sbcarlton/prosthetic-hand/IMG_2657.jpg

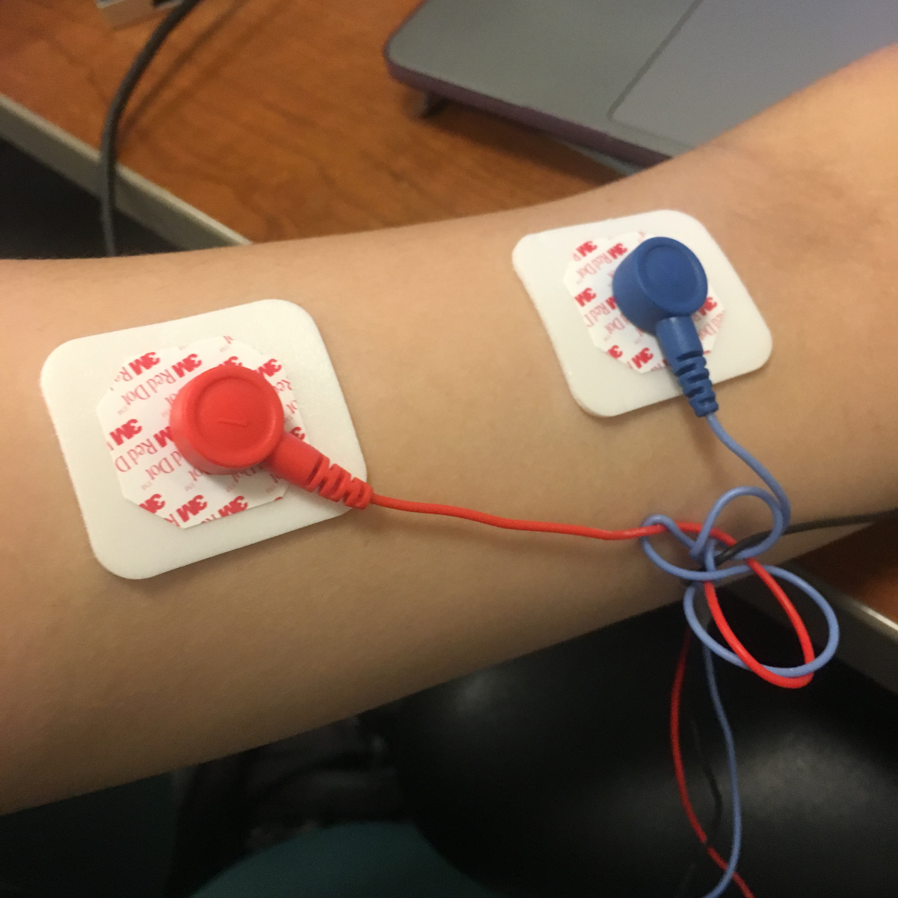
IMG_2657.jpg
