sbcarlton/prosthetic-hand/README.md

# prosthetic-hand
code for an EMG driven 3D printed prosthetic hand created as a senior project for independent research at UC Berkeley
