sbcarlton/prosthetic-hand/IMG_2658.jpg

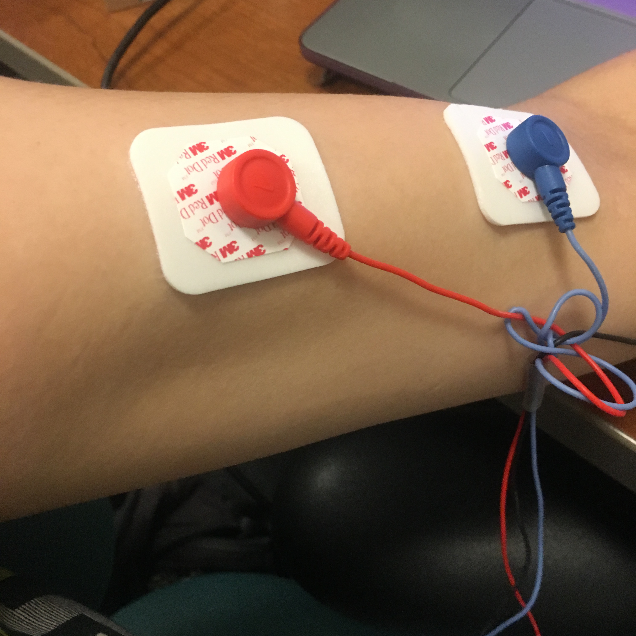
IMG_2658.jpg
