sbcarlton/prosthetic-hand/IMG_2659.jpg

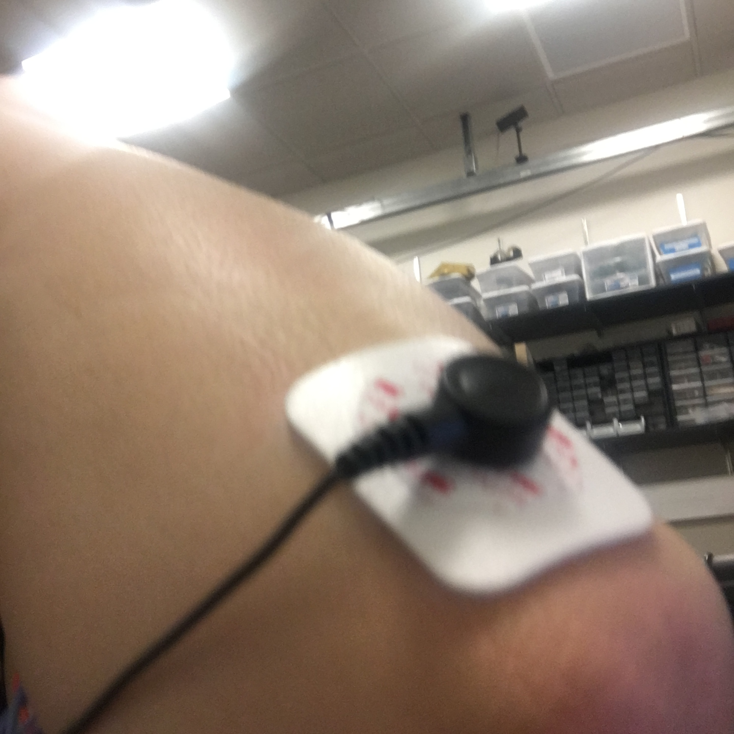
IMG_2659.jpg
