sbcarlton/prosthetic-hand/IMG_2660.jpg

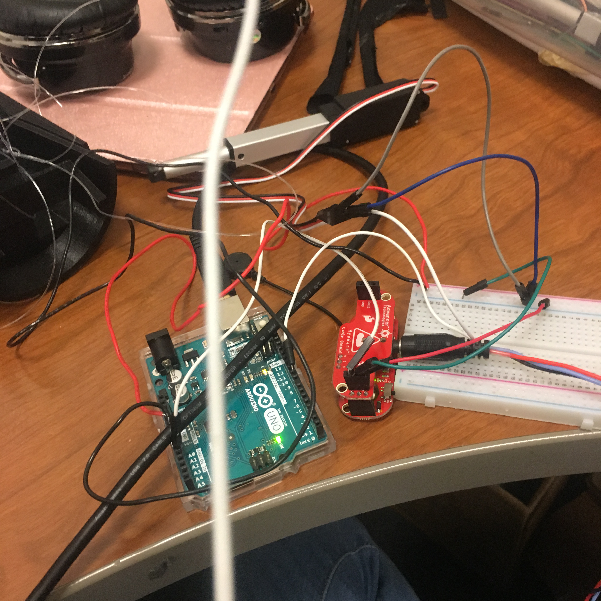
IMG_2660.jpg
