sbcarlton/prosthetic-hand/IMG_2662.jpg

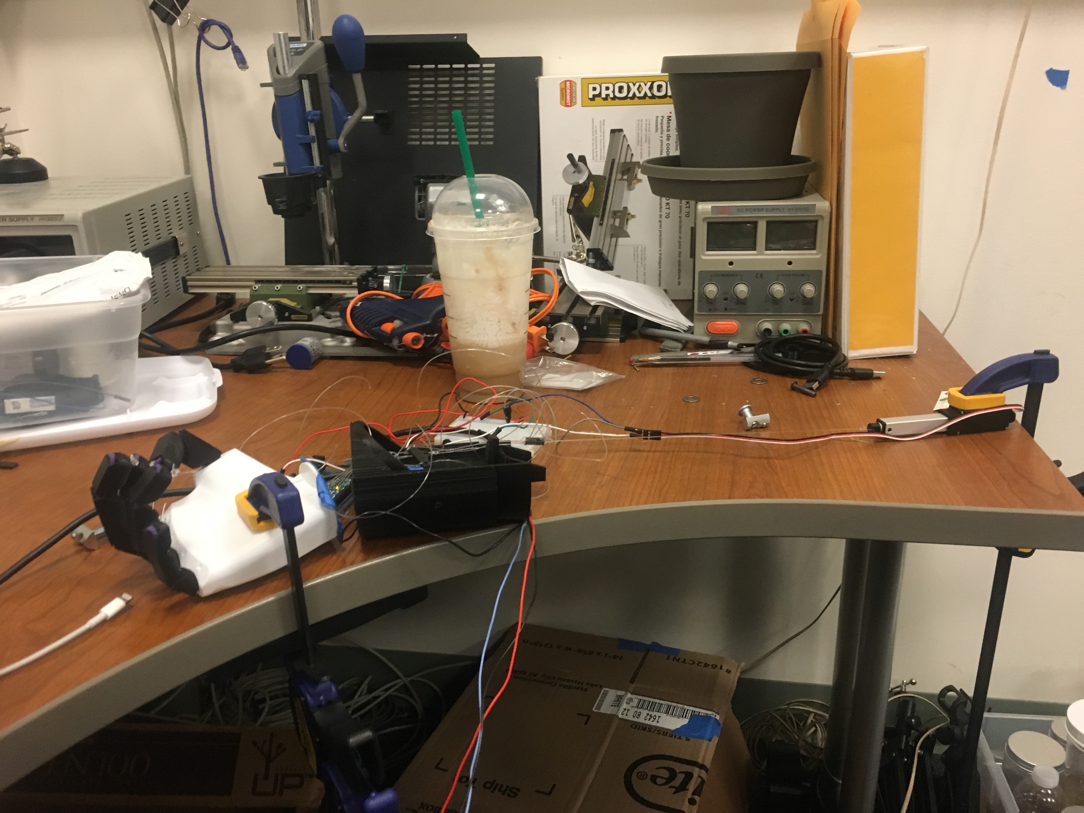
IMG_2662.jpg
