sbcarlton/prosthetic-hand/IMG_2663.jpg

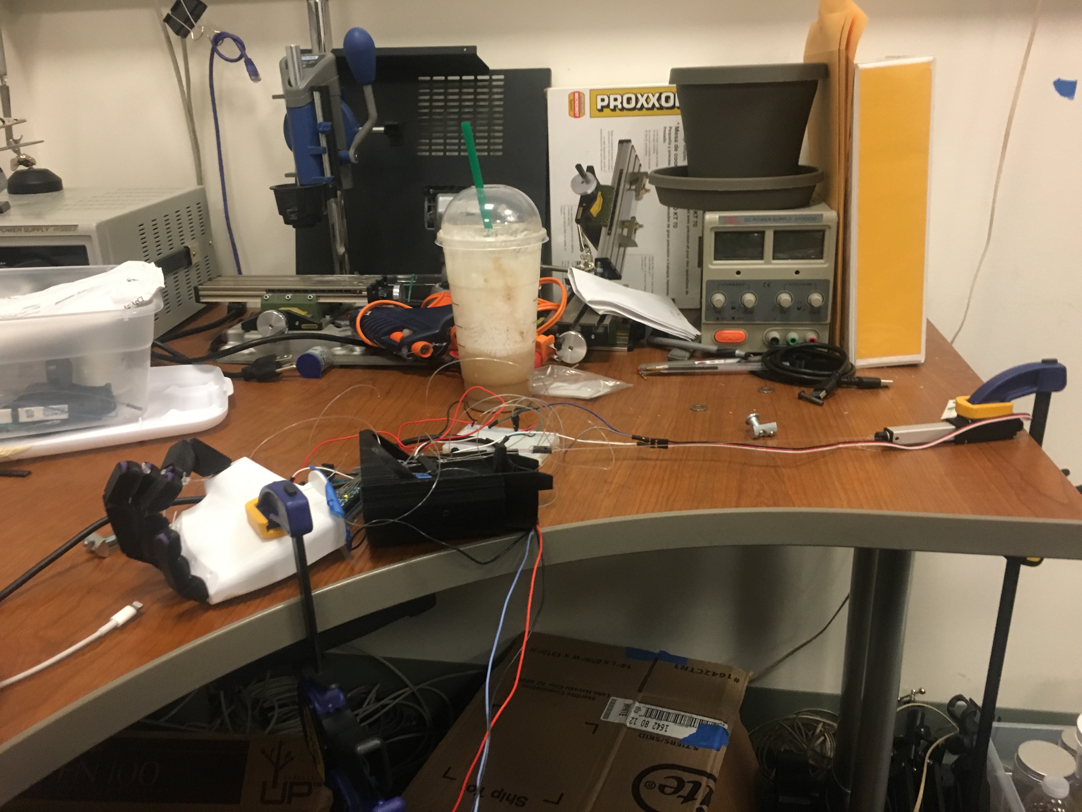
IMG_2663.jpg
