sbcarlton/prosthetic-hand/IMG_2664.jpg

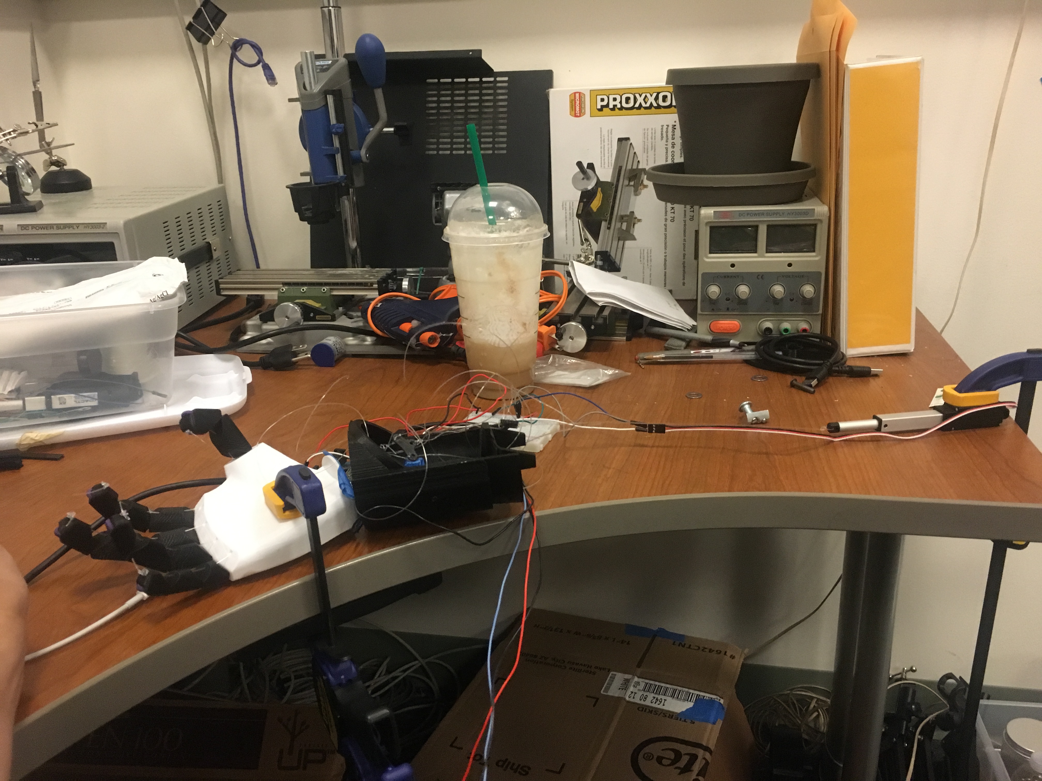
IMG_2664.jpg
