sbcarlton/prosthetic-hand/IMG_2784.jpg

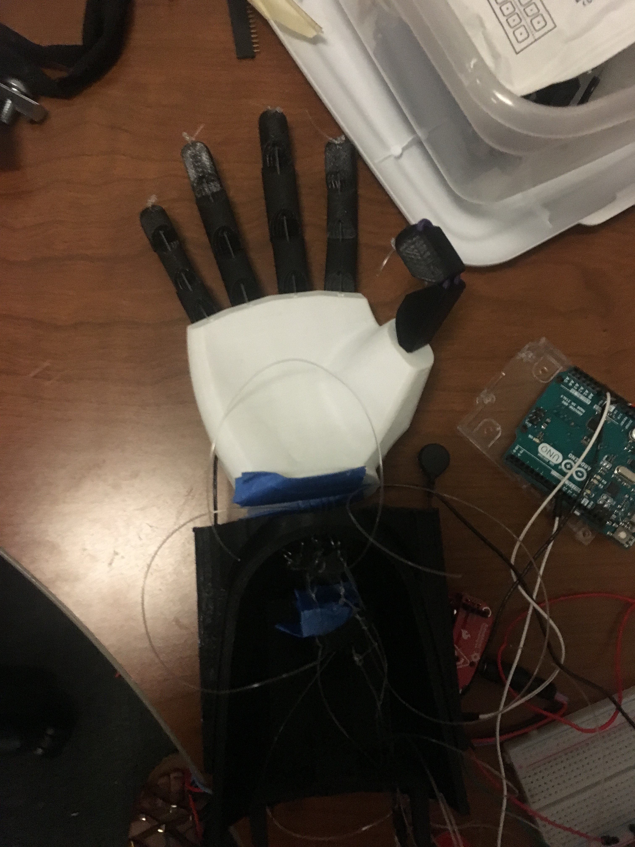
IMG_2784.jpg
