sbcarlton/prosthetic-hand/IMG_2786.jpg

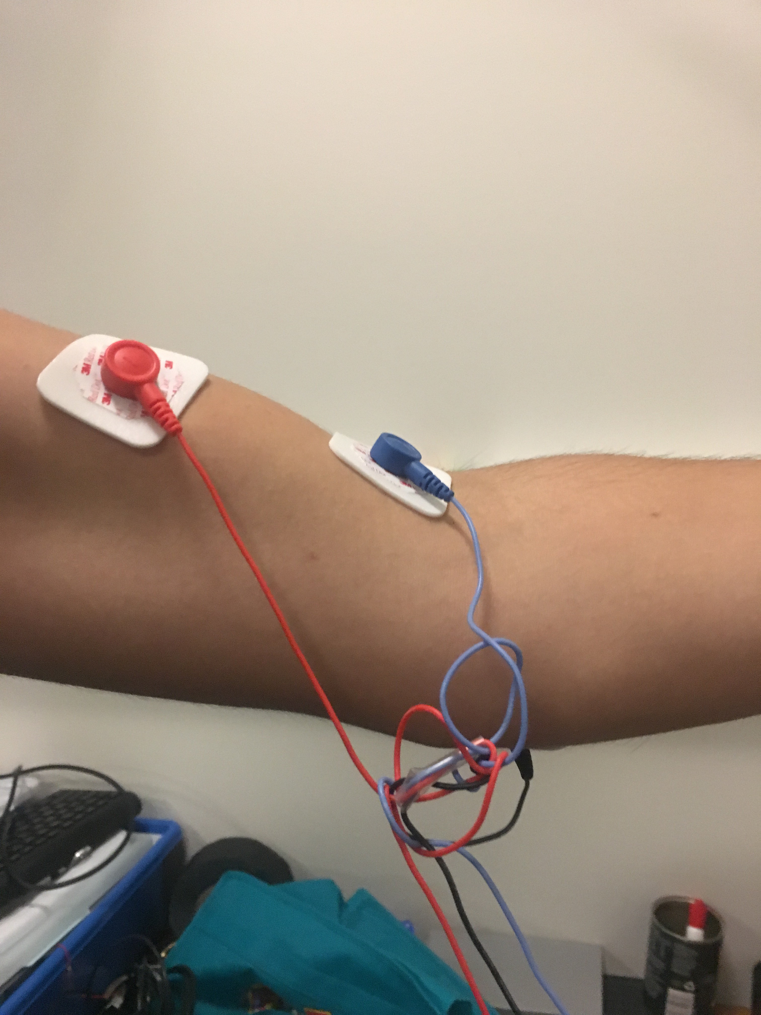
IMG_2786.jpg
