sbcarlton/prosthetic-hand/IMG_2787.jpg

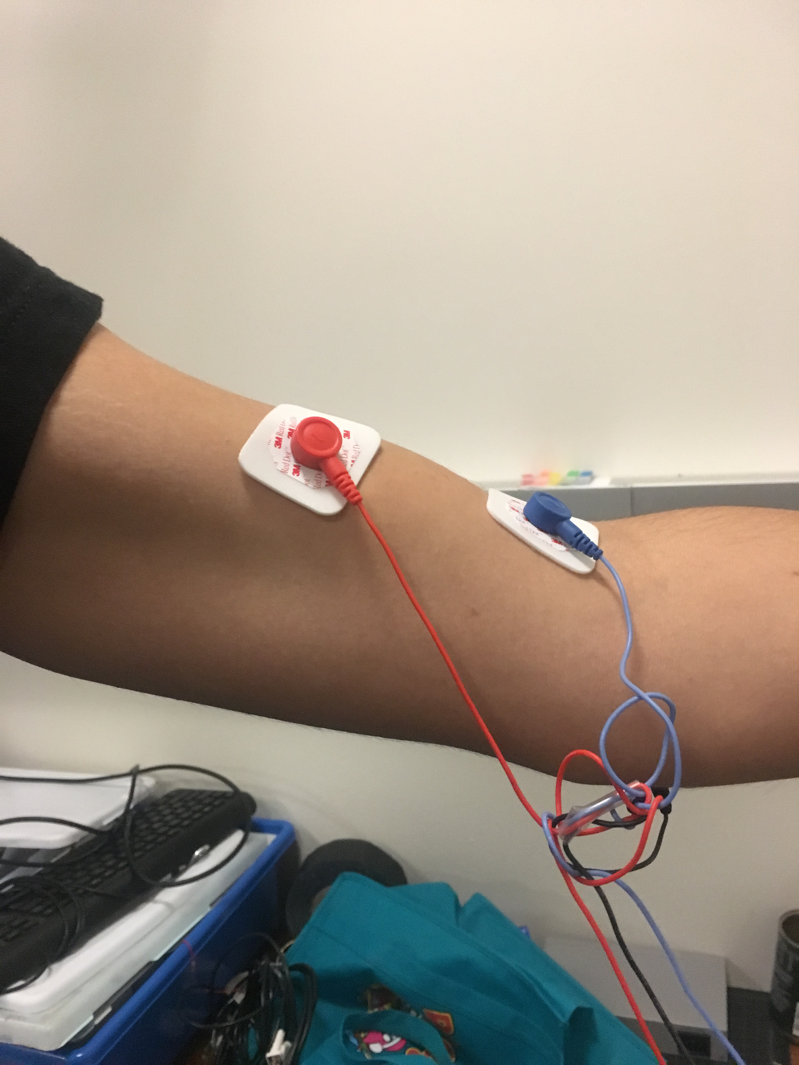
IMG_2787.jpg
