sbcarlton/prosthetic-hand/IMG_2788.jpg

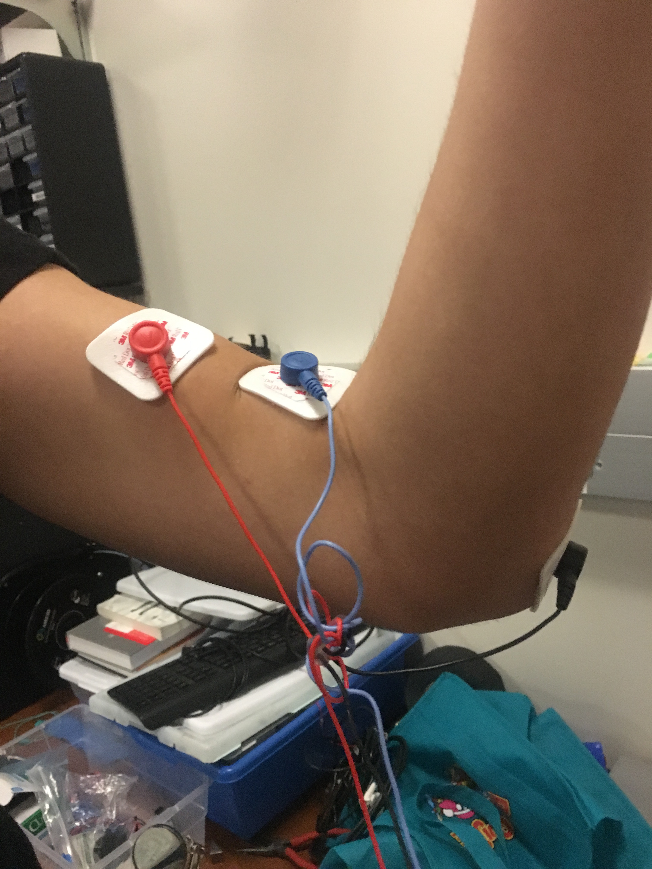
IMG_2788.jpg
