sbcarlton/prosthetic-hand/IMG_2789.jpg

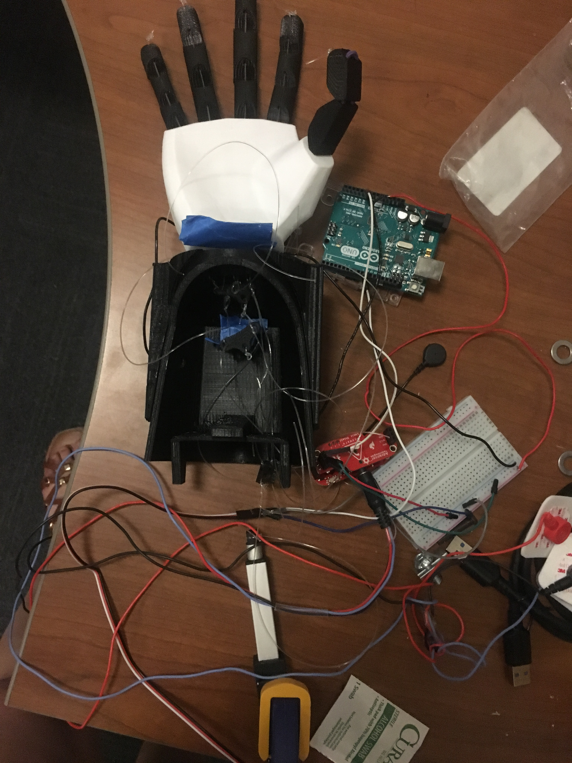
IMG_2789.jpg
