sbcarlton/prosthetic-hand/IMG_2790.jpg

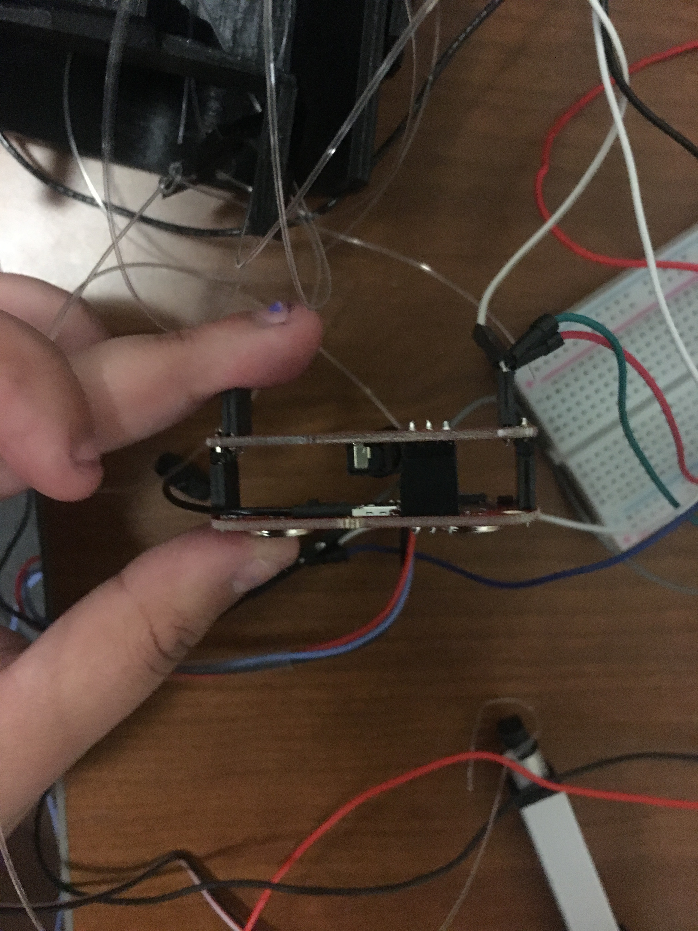
IMG_2790.jpg
