sbcarlton/prosthetic-hand/IMG_2793.jpg

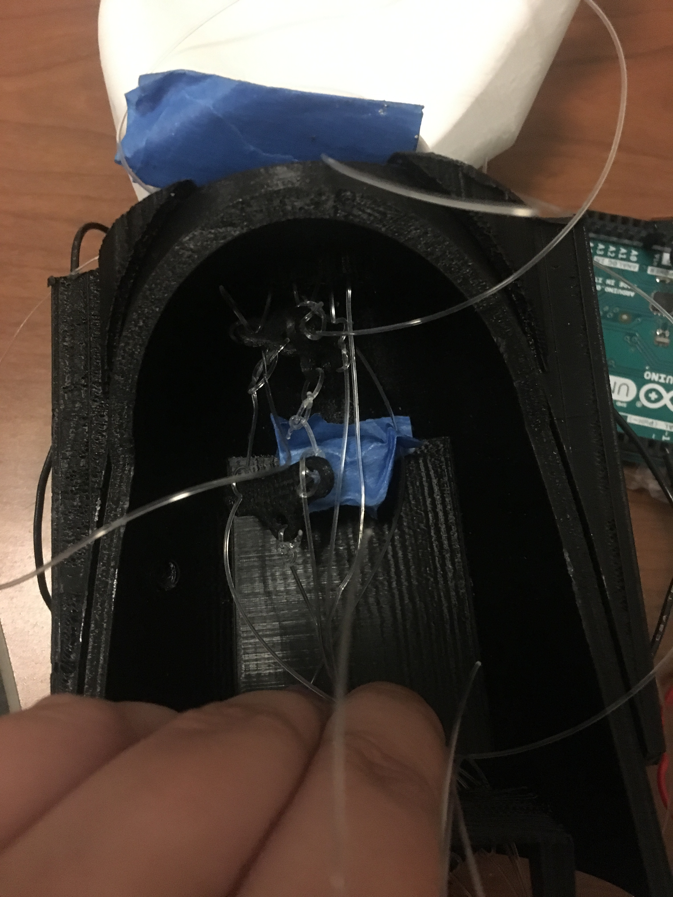
IMG_2793.jpg
