sbcarlton/prosthetic-hand/IMG_2796.jpg

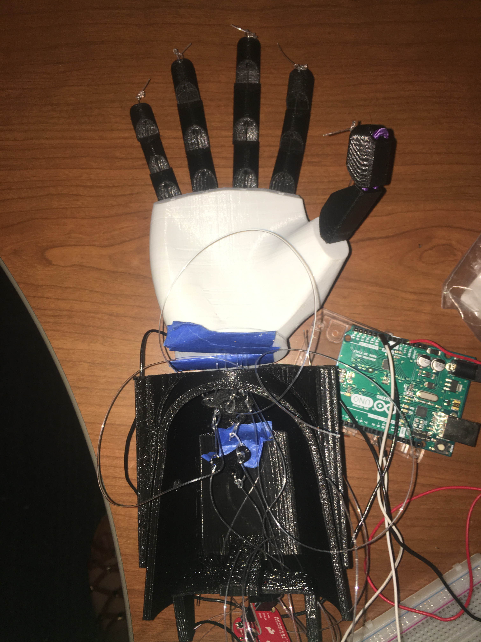
IMG_2796.jpg
