sbcarlton/prosthetic-hand/Robotic_Prosthetic_Hand/images/5bf87d471c4e8e3930c105715d8d1ddf_preview_featured.jpg

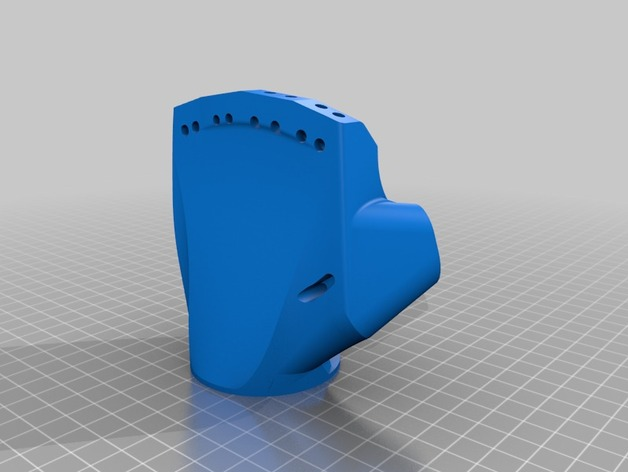
Robotic_Prosthetic_Hand/images/5bf87d471c4e8e3930c105715d8d1ddf_preview_featured.jpg
