sbcarlton/prosthetic-hand/Robotic_Prosthetic_Hand/images/9adcbccc89c3f748979c446af58fe844_preview_featured.jpg

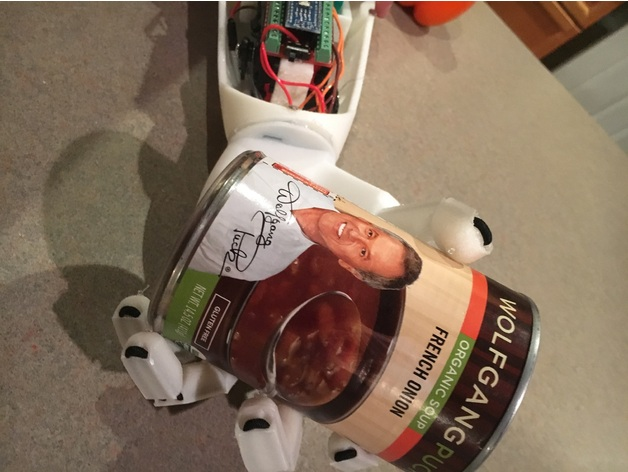
Robotic_Prosthetic_Hand/images/9adcbccc89c3f748979c446af58fe844_preview_featured.jpg
