sbcarlton/prosthetic-hand/Robotic_Prosthetic_Hand/images/32bf651d235bf7a7816415bf82ad31e1_preview_featured.JPG

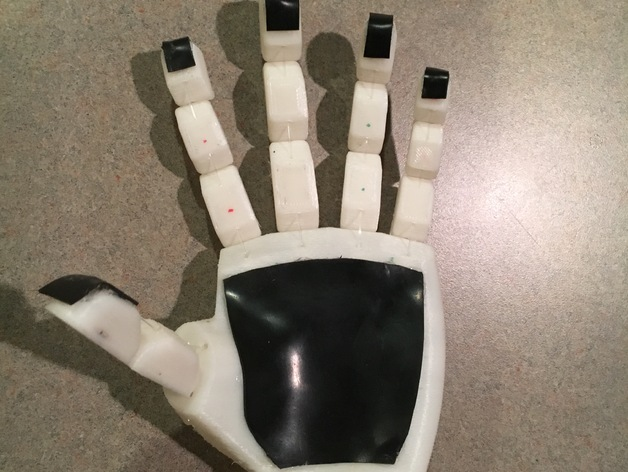
Robotic_Prosthetic_Hand/images/32bf651d235bf7a7816415bf82ad31e1_preview_featured.JPG
