sbcarlton/prosthetic-hand/Robotic_Prosthetic_Hand/images/44d62751d59e7589e10002efcaca74e4_preview_featured.JPG

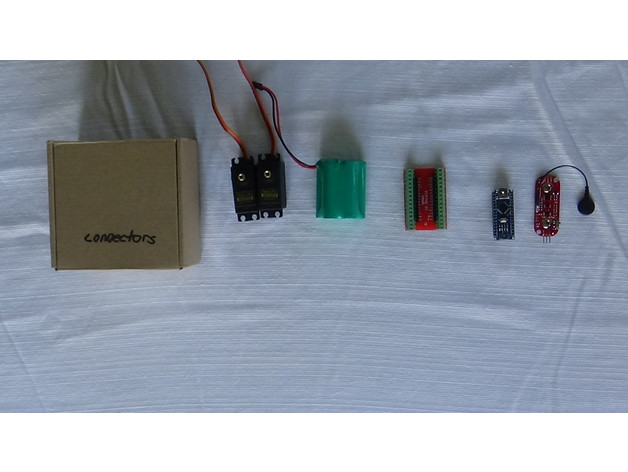
Robotic_Prosthetic_Hand/images/44d62751d59e7589e10002efcaca74e4_preview_featured.JPG
