sbcarlton/prosthetic-hand/Robotic_Prosthetic_Hand/images/73d3aff5ccb3abafcd1abfeff3e0f53e_preview_featured.jpg

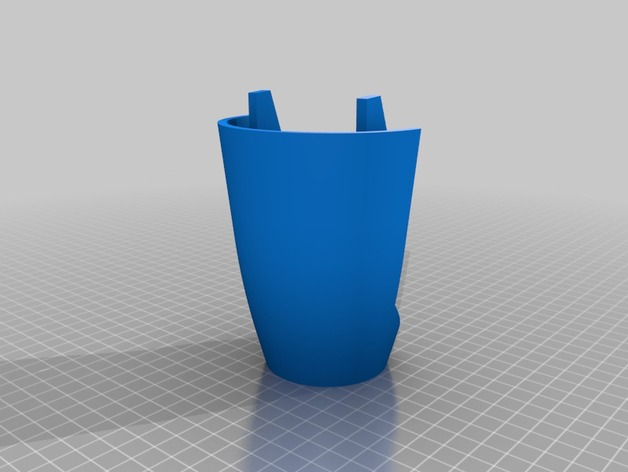
Robotic_Prosthetic_Hand/images/73d3aff5ccb3abafcd1abfeff3e0f53e_preview_featured.jpg
