sbcarlton/prosthetic-hand/Robotic_Prosthetic_Hand/images/95ef820563cf4c97e35bc5cfcc1ec401_preview_featured.jpg

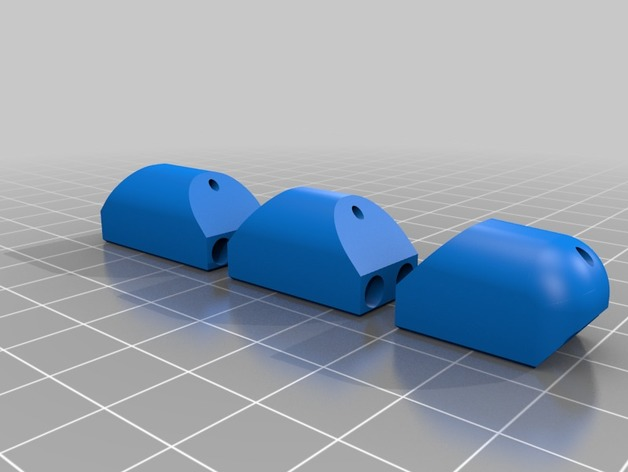
Robotic_Prosthetic_Hand/images/95ef820563cf4c97e35bc5cfcc1ec401_preview_featured.jpg
