sbcarlton/prosthetic-hand/Robotic_Prosthetic_Hand/images/307f6f0869bcb23cfadc7e113434cdfe_preview_featured.jpg

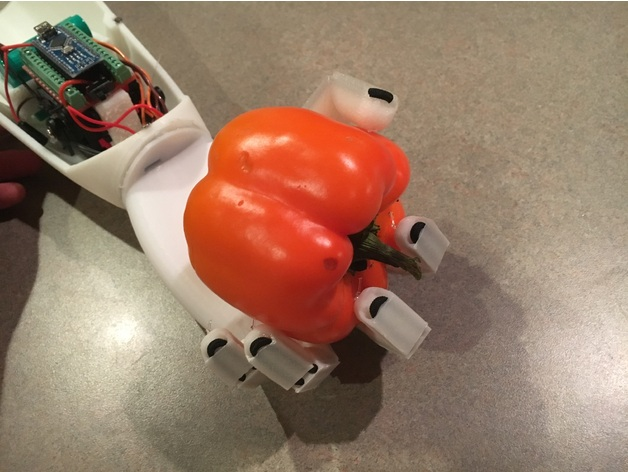
Robotic_Prosthetic_Hand/images/307f6f0869bcb23cfadc7e113434cdfe_preview_featured.jpg
