sbcarlton/prosthetic-hand/Robotic_Prosthetic_Hand/images/545bb06ac58f621accbe60c1915f54e6_preview_featured.jpg

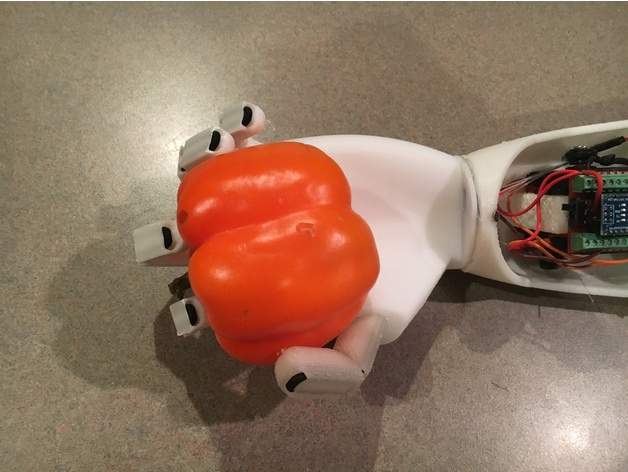
Robotic_Prosthetic_Hand/images/545bb06ac58f621accbe60c1915f54e6_preview_featured.jpg
