sbcarlton/prosthetic-hand/Robotic_Prosthetic_Hand/images/6564a175ac4e20c3febf0e6449c3d8bb_preview_featured.jpg

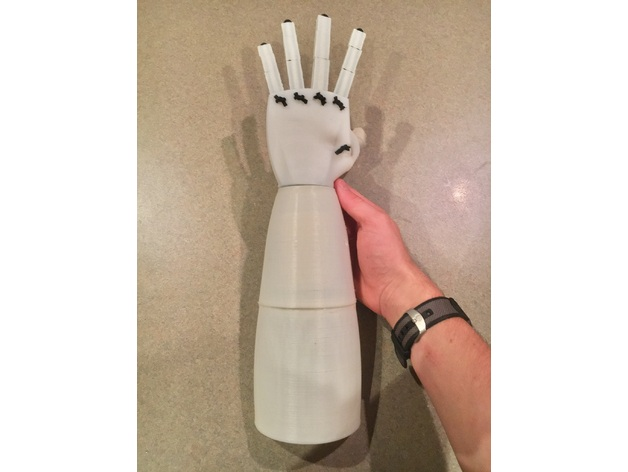
Robotic_Prosthetic_Hand/images/6564a175ac4e20c3febf0e6449c3d8bb_preview_featured.jpg
