sbcarlton/prosthetic-hand/Robotic_Prosthetic_Hand/images/32909d81c91412d3fa15cc0ddb981acb_preview_featured.jpg

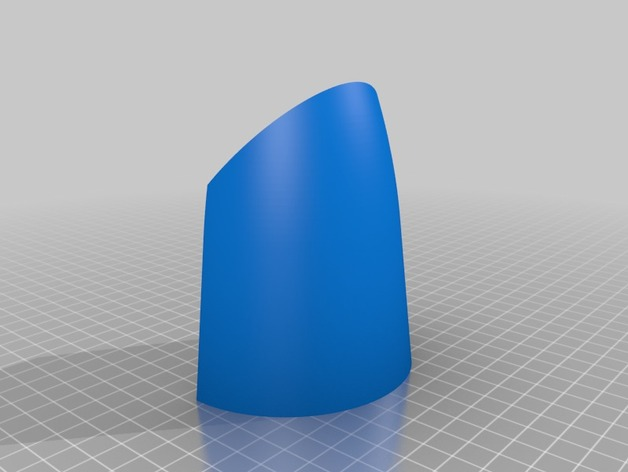
Robotic_Prosthetic_Hand/images/32909d81c91412d3fa15cc0ddb981acb_preview_featured.jpg
