sbcarlton/prosthetic-hand/Robotic_Prosthetic_Hand/images/7610608f42615563228bc9fcee39c791_preview_featured.jpg

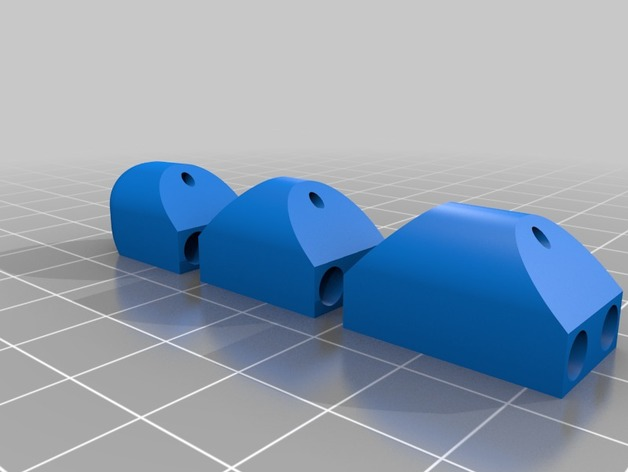
Robotic_Prosthetic_Hand/images/7610608f42615563228bc9fcee39c791_preview_featured.jpg
