sbcarlton/prosthetic-hand/Robotic_Prosthetic_Hand/images/b14e3ddfbdfe2a040a8be1c0446fe131_preview_featured.jpg

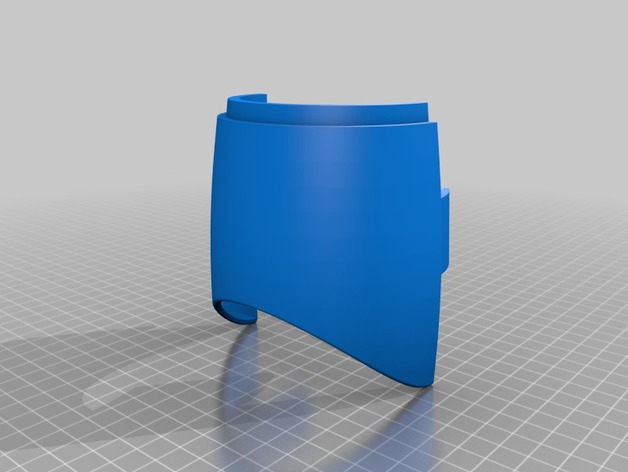
Robotic_Prosthetic_Hand/images/b14e3ddfbdfe2a040a8be1c0446fe131_preview_featured.jpg
