sbcarlton/prosthetic-hand/Robotic_Prosthetic_Hand/images/b598eadae24f4305748881fc7f42691f_preview_featured.jpg

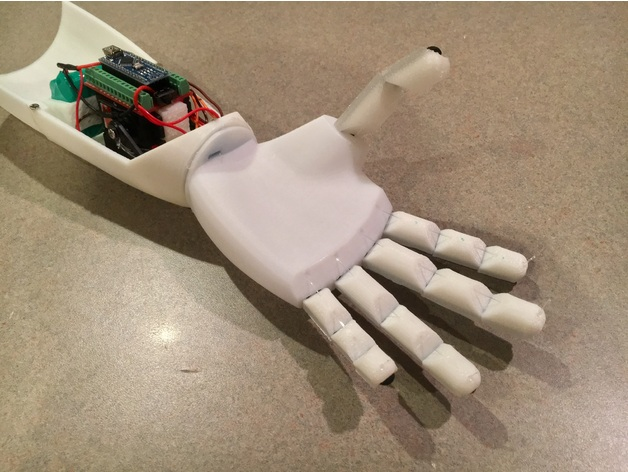
Robotic_Prosthetic_Hand/images/b598eadae24f4305748881fc7f42691f_preview_featured.jpg
