sbcarlton/prosthetic-hand/Robotic_Prosthetic_Hand/images/dbe66f43a5eda763f0ff32a2039e6df4_preview_featured.JPG

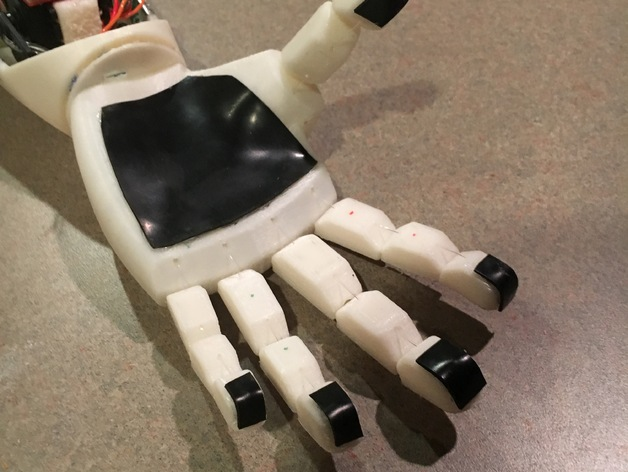
Robotic_Prosthetic_Hand/images/dbe66f43a5eda763f0ff32a2039e6df4_preview_featured.JPG
