sbcarlton/prosthetic-hand/Robotic_Prosthetic_Hand/images/dcc57bf91c1c912be0ee6a336cb7673d_preview_featured.jpg

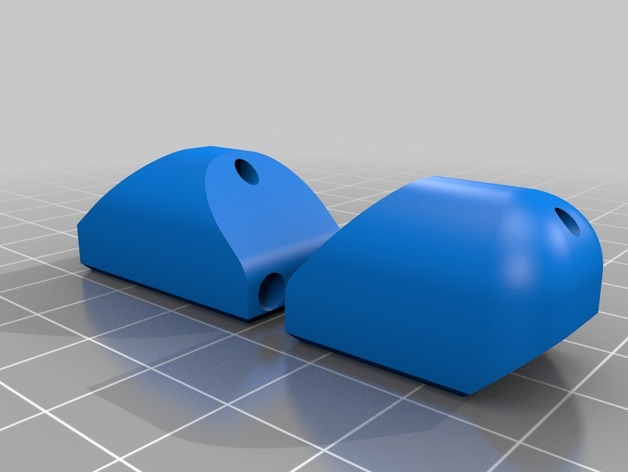
Robotic_Prosthetic_Hand/images/dcc57bf91c1c912be0ee6a336cb7673d_preview_featured.jpg
