sbcarlton/prosthetic-hand/Robotic_Prosthetic_Hand/images/e57f64609a7e4432f086a8b89934f109_preview_featured.jpg

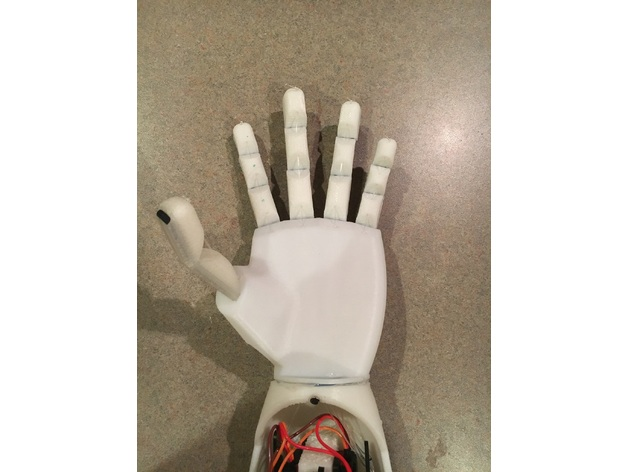
Robotic_Prosthetic_Hand/images/e57f64609a7e4432f086a8b89934f109_preview_featured.jpg
