sbcarlton/prosthetic-hand/Robotic_Prosthetic_Hand/images/eb1e3176798db21858784055478ce540_preview_featured.jpg

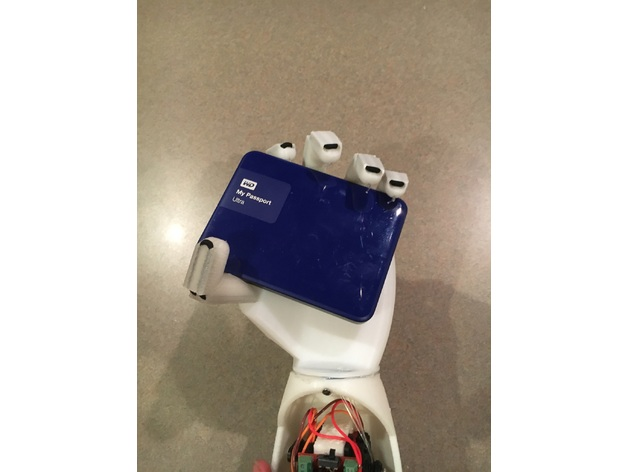
Robotic_Prosthetic_Hand/images/eb1e3176798db21858784055478ce540_preview_featured.jpg
