sbcarlton/prosthetic-hand/Robotic_Prosthetic_Hand/images/eb18b24c626825f0cc107db845431f8f_preview_featured.jpg

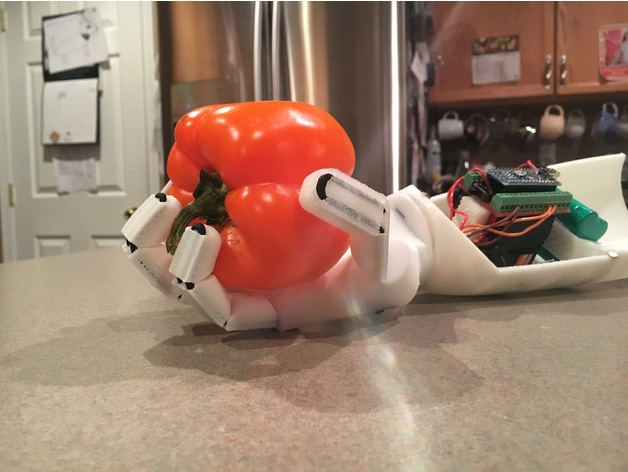
Robotic_Prosthetic_Hand/images/eb18b24c626825f0cc107db845431f8f_preview_featured.jpg
