sbcarlton/prosthetic-hand/Robotic_Prosthetic_Hand/images/efd8cdcd70365ec9b41dd28bba91d32c_preview_featured.jpg

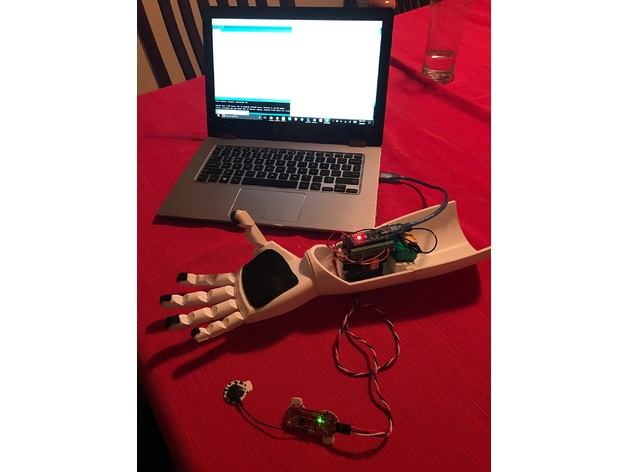
Robotic_Prosthetic_Hand/images/efd8cdcd70365ec9b41dd28bba91d32c_preview_featured.jpg
