sbcarlton/prosthetic-hand/Robotic_Prosthetic_Hand/images/f857410ee60ef76669d72bfa062a1159_preview_featured.jpg

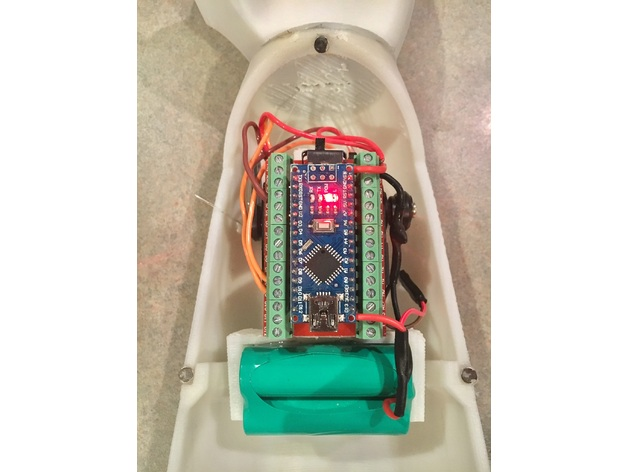
Robotic_Prosthetic_Hand/images/f857410ee60ef76669d72bfa062a1159_preview_featured.jpg
