sbcarlton/prosthetic-hand/Robotic_Prosthetic_Hand/images/fbd8e0ddd81bd475f3afb1273ed80551_preview_featured.jpg

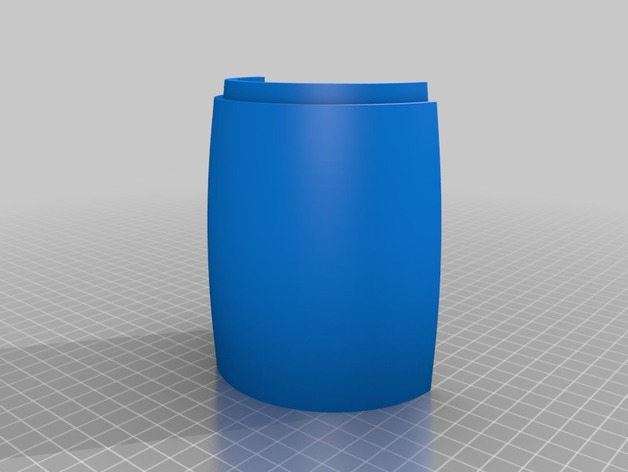
Robotic_Prosthetic_Hand/images/fbd8e0ddd81bd475f3afb1273ed80551_preview_featured.jpg
