sbcarlton/prosthetic-hand/Robotic_Prosthetic_Hand/files/ArmPiece_1.stl

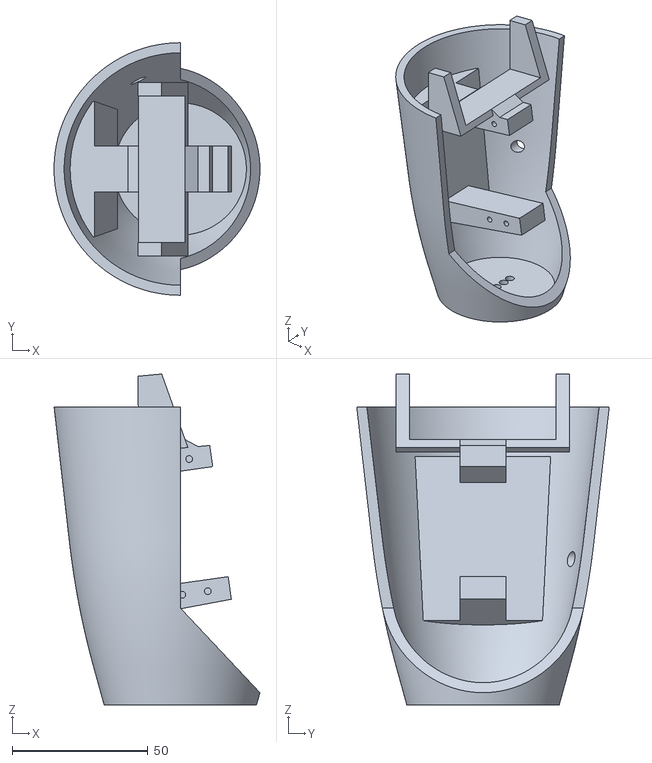
[picture p48: CAD file, 2019-05-14]
Robotic_Prosthetic_Hand/files/ArmPiece_1.stl
76.0 x 93.2 x 122.1
