sbcarlton/prosthetic-hand/whippletree_tensioner_for_prosthetic_hands.stl

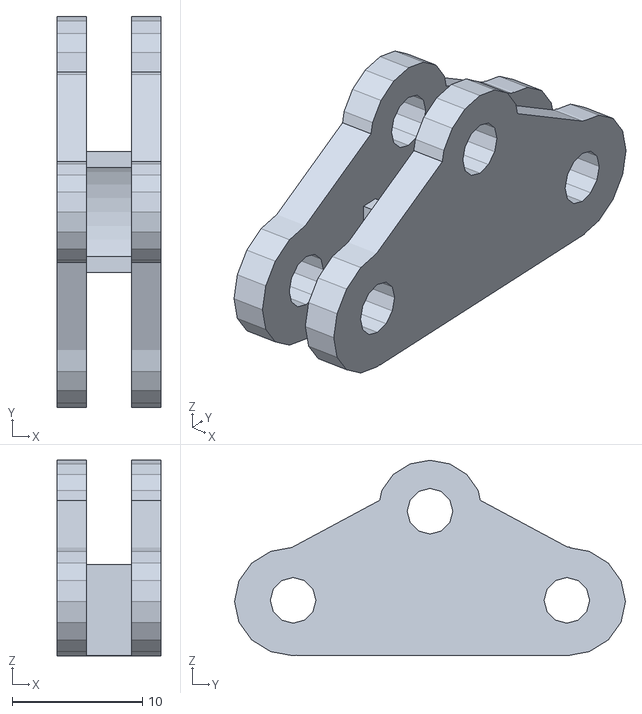
[picture p49: CAD file, 2019-05-14]
whippletree_tensioner_for_prosthetic_hands.stl
8.00 x 30.0 x 15.0
