sbcarlton/prosthetic-hand/Robotic_Prosthetic_Hand/files/Piece_1.dxf

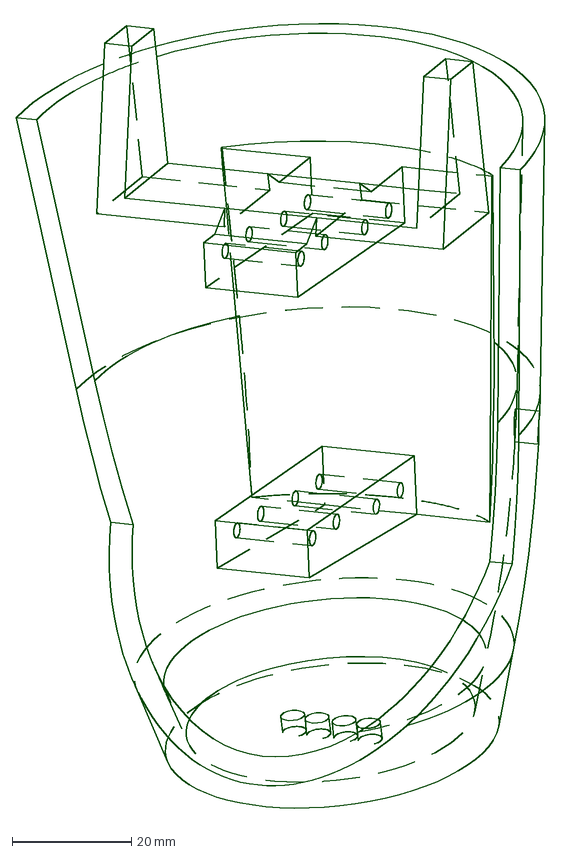
[picture p50: CAD file, 2019-05-14]
Robotic_Prosthetic_Hand/files/Piece_1.dxf
92.4 x 133.9 mm
