sbcarlton/prosthetic-hand/Robotic_Prosthetic_Hand/files/Fingerdesign_ALL.dxf

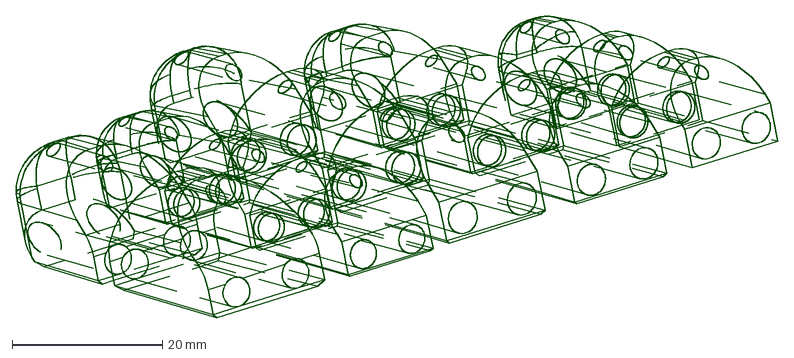
[picture p51: CAD file, 2019-05-14]
Robotic_Prosthetic_Hand/files/Fingerdesign_ALL.dxf
101.3 x 40.1 mm
