sbcarlton/prosthetic-hand/Robotic_Prosthetic_Hand/files/PC2-2_Cover.dxf

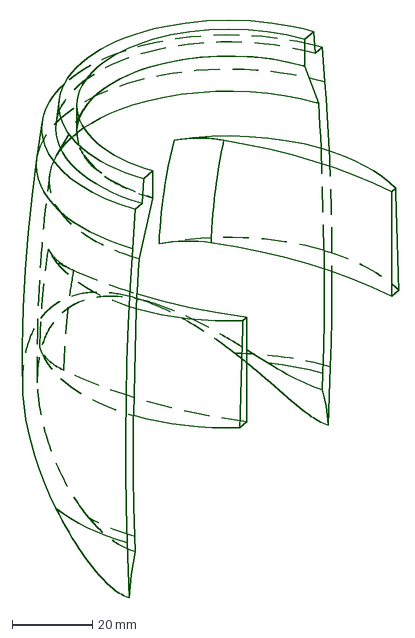
[picture p52: CAD file, 2019-05-14]
Robotic_Prosthetic_Hand/files/PC2-2_Cover.dxf
95.2 x 144.6 mm
