sbcarlton/prosthetic-hand/Robotic_Prosthetic_Hand/files/Fingerdesign_8-7_Ring.stl

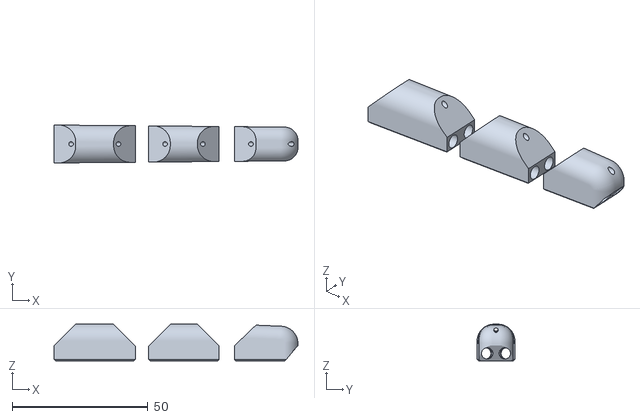
[picture p53: CAD file, 2019-05-14]
Robotic_Prosthetic_Hand/files/Fingerdesign_8-7_Ring.stl
90.0 x 14.0 x 13.5
