sbcarlton/prosthetic-hand/Robotic_Prosthetic_Hand/files/ArmPiece_2.stl

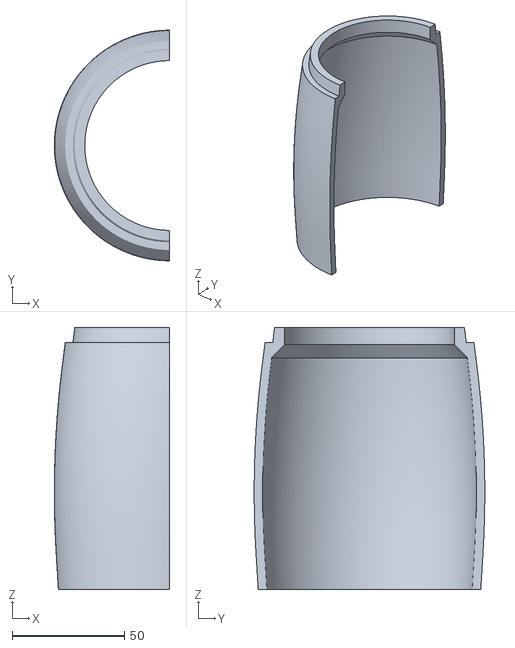
[picture p54: CAD file, 2019-05-14]
Robotic_Prosthetic_Hand/files/ArmPiece_2.stl
51.4 x 102.7 x 116.7
