sbcarlton/prosthetic-hand/Robotic_Prosthetic_Hand/files/Hand4.dxf

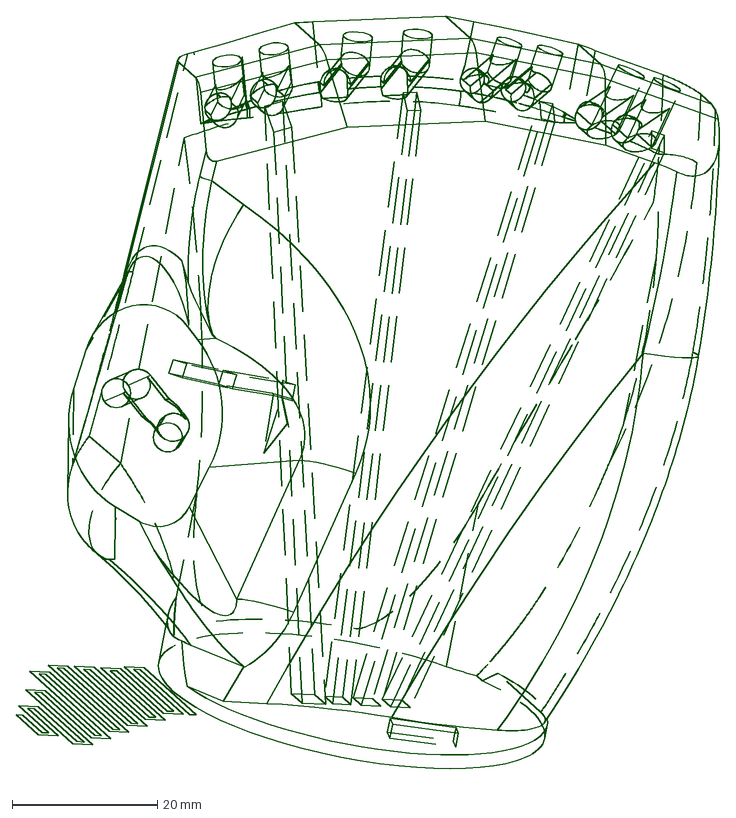
[picture p55: CAD file, 2019-05-14]
Robotic_Prosthetic_Hand/files/Hand4.dxf
96.8 x 104.9 mm
