sbcarlton/prosthetic-hand/Robotic_Prosthetic_Hand/files/Fingerdesign_8-7_Pinky.stl

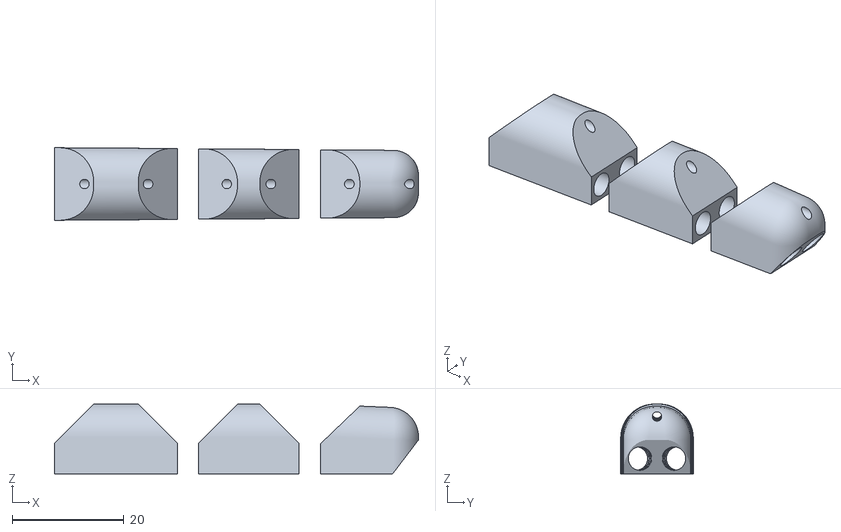
[picture p56: CAD file, 2019-05-14]
Robotic_Prosthetic_Hand/files/Fingerdesign_8-7_Pinky.stl
65.2 x 13.0 x 12.5
