sbcarlton/prosthetic-hand/Robotic_Prosthetic_Hand/files/Fingerdesign_8-7_Index.stl

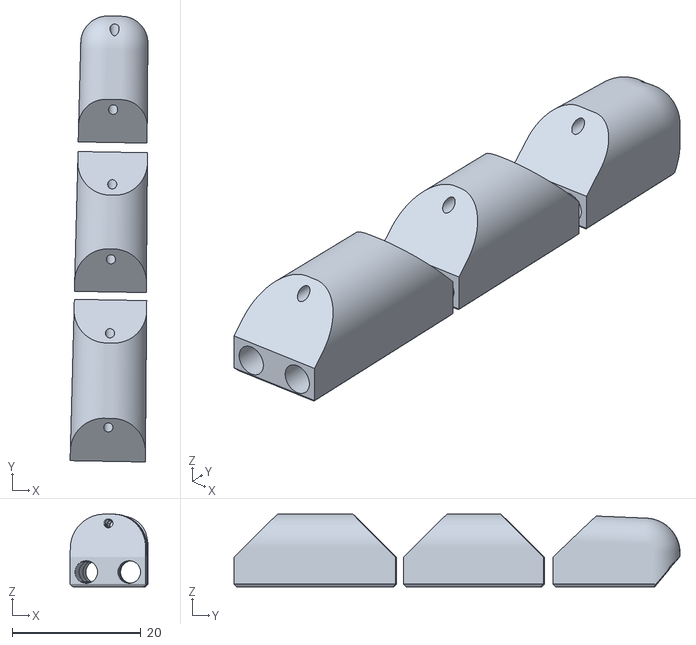
[picture p57: CAD file, 2019-05-14]
Robotic_Prosthetic_Hand/files/Fingerdesign_8-7_Index.stl
12.1 x 69.4 x 11.3
