sbcarlton/prosthetic-hand/Robotic_Prosthetic_Hand/files/Fingerdesign_8-7_Middle.stl

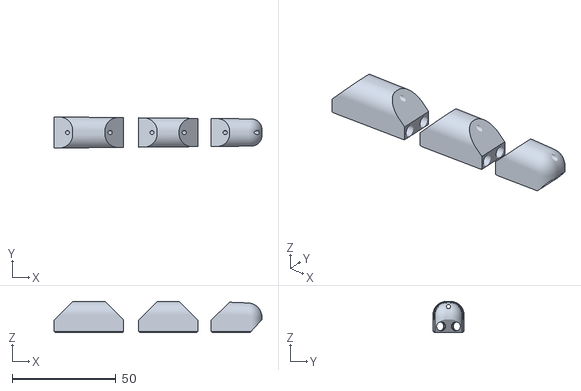
[picture p58: CAD file, 2019-05-14]
Robotic_Prosthetic_Hand/files/Fingerdesign_8-7_Middle.stl
100.0 x 15.0 x 15.0
