sbcarlton/prosthetic-hand/Robotic_Prosthetic_Hand/files/Fingerdesign_8-7_Thumb.stl

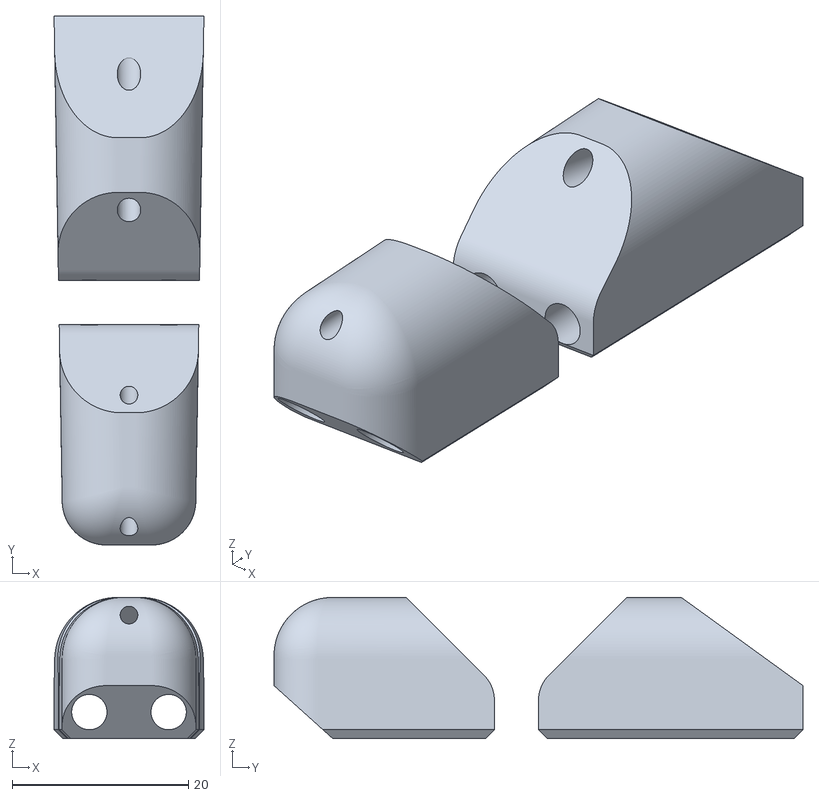
[picture p59: CAD file, 2019-05-14]
Robotic_Prosthetic_Hand/files/Fingerdesign_8-7_Thumb.stl
17.0 x 60.0 x 16.0
