sbcarlton/prosthetic-hand/Robotic_Prosthetic_Hand/files/Piece_2.dxf

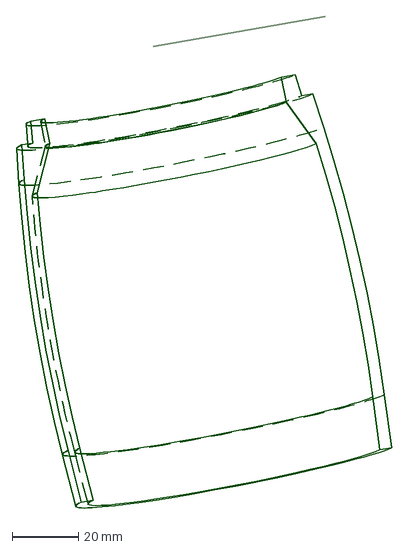
[picture p60: CAD file, 2019-05-14]
Robotic_Prosthetic_Hand/files/Piece_2.dxf
113.6 x 149.6 mm
