sbcarlton/prosthetic-hand/Robotic_Prosthetic_Hand/files/PC1_Cover.stl

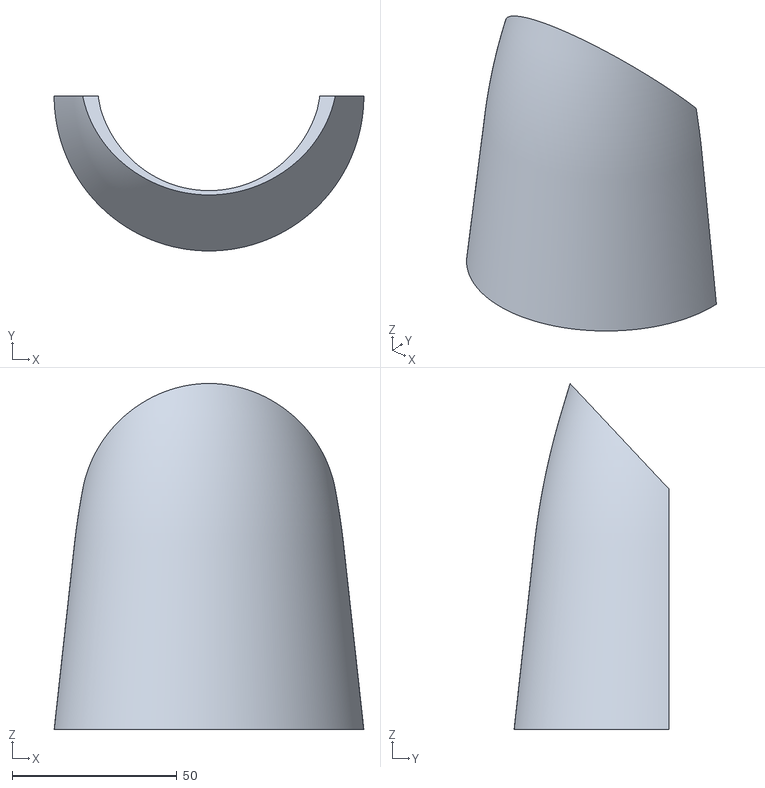
[picture p61: CAD file, 2019-05-14]
Robotic_Prosthetic_Hand/files/PC1_Cover.stl
94.0 x 47.0 x 105.0
