sbcarlton/prosthetic-hand/(list of files, cad)

Other CAD files:
Robotic_Prosthetic_Hand/files/PC1_Cover.dxf
