sbcarlton/prosthetic-hand/(list of files, drawings)

Other design files:
emg wiring.fzz
