sbcarlton/prosthetic-hand/(commit log)

2019-05-14 adding wiring diagram
    [emg wiring.fzz]
2019-05-14 STL files from https://www.thingiverse.com/thing:1691704
    [ArmPiece_1.stl, ArmPiece_2.stl, Fingerdesign_8-7_Index.stl, Fingerdesign_8-7_Middle.stl, Fingerdesign_8-7_Pinky.stl, Fingerdesign_8-7_Ring.stl, Fingerdesign_8-7_Thumb.stl, Fingerdesign_ALL.dxf]
2019-05-14 Whipple tree tensioner from https://www.youmagine.com/designs/adaptive-grip-mechanism-for-prosthetic-hand
    [whippletree_tensioner_for_prosthetic_hands.stl]
2019-05-14 analog potentiomer
    used to figure out the correct degrees for the linear servo
    [AnalogInputpotentiometer.ino]
