sbcarlton/prosthetic-hand/IMG_2791.jpg

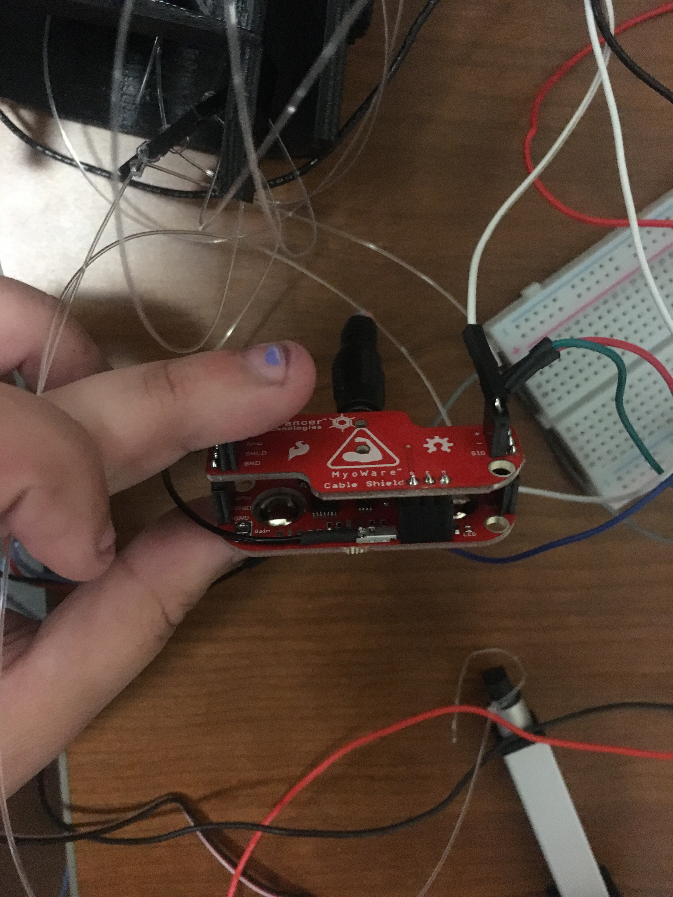
IMG_2791.jpg
