sbcarlton/prosthetic-hand/IMG_2795.jpg

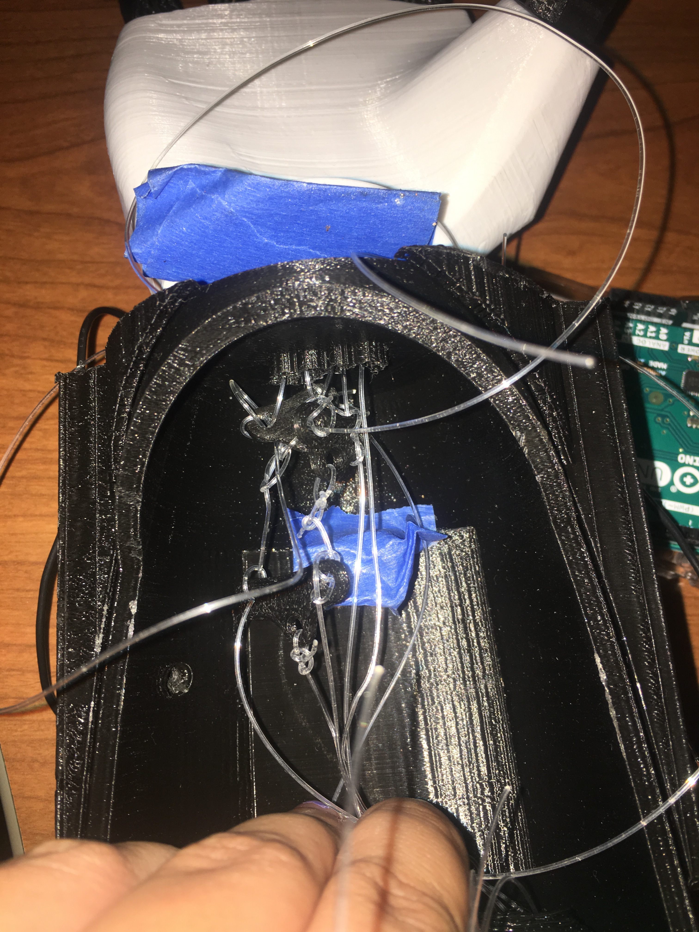
IMG_2795.jpg
